RuizDev-117/BioGelato/hardware/ENCLOSURE/Utils/reference.png

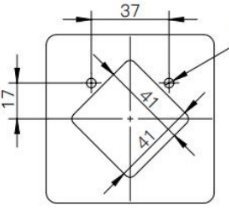
hardware/ENCLOSURE/Utils/reference.png
