RuizDev-117/BioGelato/hardware/PCB/BOM.xlsx

No. | Quantity | Comment | Designator | Footprint | Value | Manufacturer Part | Manufacturer | Supplier Part | Supplier | JLCPCB Stock | JLCPCB Price | Category
1 | 2 | 2.7nF | C1,C17 | C0805 | 2.7nF | CL21B272KBANNNC | SAMSUNG(三星) | C170119 | LCSC | 8417 | 0.0036 | Capacitors:Multilayer Ceramic Capacitors MLCC - SMD/SMT
2 | 4 | 10uF | C2,C4,C13,C14 | C0805 | 10uF | CL21A106KAYNNNE | SAMSUNG(三星) | C15850 | LCSC | 8339426 | 0.0129 | Capacitors:Multilayer Ceramic Capacitors MLCC - SMD/SMT
3 | 4 | 100nF | C3,C5,C9,C15 | C0805 | 100nF | CL21B104KCFNNNE | SAMSUNG(三星) | C28233 | LCSC | 1776398 | 0.006 | Capacitors:Multilayer Ceramic Capacitors MLCC - SMD/SMT
4 | 1 | 1uF | C6 | C0805 | 1uF | CL21B105KBFNNNE | SAMSUNG(三星) | C28323 | LCSC | 4206251 | 0.0066 | Capacitors:Multilayer Ceramic Capacitors MLCC - SMD/SMT
5 | 5 | 22uF | C7,C8,C10,C11,C12 | C0805 | 22uF | CL21A226MAQNNNE | SAMSUNG(三星) | C45783 | LCSC | 5388746 | 0.0384 | Capacitors:Multilayer Ceramic Capacitors MLCC - SMD/SMT
6 | 1 | 10nF | C16 | C0805 | 10nF | CL21B103KBANNNC | SAMSUNG(三星) | C1710 | LCSC | 3236198 | 0.002 | Capacitors:Multilayer Ceramic Capacitors MLCC - SMD/SMT
7 | 1 | SS54 | D1 | SMA_L4.4-W2.8-LS5.4-R-RD |  | SS54 | MDD(辰达半导体) | C22452 | LCSC | 2501779 | 0.0066 | Diodes:Schottky Diodes
8 | 1 | SMAJ16CA-E3/61 | D2 | SMA_L4.2-W2.7-LS5.1-BI |  | SMAJ16CA-E3/61 | VISHAY(威世) | C1973110 | LCSC | 29761 | 0.0214 | Circuit Protection:ESD and Surge Protection (TVS/ESD)
9 | 10 | ESD5Z5.0T1G | D3,D4,D5,D6,D7,D8,D9,D10,D11,D12 | SOD-523F_L1.2-W0.8-LS1.7-RD |  | ESD5Z5.0T1G | onsemi(安森美) | C82044 | LCSC | 351374 | 0.0055 | Circuit Protection:ESD and Surge Protection (TVS/ESD)
10 | 1 | BZT52C6V2-7-F | D13 | SOD-123_L2.7-W1.6-LS3.7-RD-1 |  | BZT52C6V2-7-F | DIODES(美台) | C397931 | LCSC | 20504 | 0.007 | Diodes:Zener Diodes
11 | 1 | 12v DC 2A | DC1 | DC-IN-TH_DC005-T20 |  | DC005-T20 | SOFNG(硕方) | C111567 | LCSC | 14940 | 0.0346 | Connectors:DC Power Connectors
12 | 1 | MPZ2012S221AT000 | L1 | L0805 |  | MPZ2012S221AT000 | TDK | C76818 | LCSC | 132158 | 0.0049 | Filters:Ferrite Beads
13 | 1 | 4.7uH | L2 | IND-SMD_L12.0-W12.0_CDRH127XX | 4.7uH | CDRH127L125NP-4R7NC | Sumida(胜美达) | C2835875 | LCSC | 1759 | 0.1589 | Inductors, Coils, Chokes:Power Inductors
14 | 3 | MMBT3904LT1G | Q1,Q4,Q6 | SOT-23-3_L2.9-W1.6-P1.90-LS2.8-BR |  | MMBT3904LT1G | onsemi(安森美) | C81464 | LCSC | 2249115 | 0.0026 | Transistors/Thyristors:Bipolar (BJT)
15 | 1 | IRLZ44N(UMW) | Q2 | TO-220-3_L10.2-W4.5-P2.54-L |  | IRLZ44N(UMW) | UMW(友台半导体) | C42370423 | LCSC | 6914 | 0.0573 | Transistors/Thyristors:MOSFETs
16 | 1 | MMBT3906LT1G | Q3 | SOT-23-3_L2.9-W1.3-P1.90-LS2.4-BR |  | MMBT3906LT1G | onsemi(安森美) | C53444 | LCSC | 1092785 | 0.0029 | Transistors/Thyristors:Bipolar (BJT)
17 | 2 | AO3401A | Q5,Q7 | SOT-23_L2.9-W1.3-P1.90-LS2.4-BR |  | AO3401A | AOS | C15127 | LCSC | 752896 | 0.0145 | Transistors/Thyristors:MOSFETs
18 | 3 | 10Ω | R1,R3,R5 | R0805_NEW | 10Ω | 0805W8F100JT5E | UNI-ROYAL(厚声) | C17415 | LCSC | 6900906 | 0.0007 | Resistors:Chip Resistor - Surface Mount
19 | 2 | 1kΩ | R2,R6 | R0805 | 1kΩ | 0805W8F1001T5E | UNI-ROYAL(厚声) | C17513 | LCSC | 25333230 | 0.0007 | Resistors:Chip Resistor - Surface Mount
20 | 2 | 100kΩ | R4,R15 | R0805 | 100kΩ | 0805W8F1003T5E | UNI-ROYAL(厚声) | C149504 | LCSC | 5377733 | 0.0009 | Resistors:Chip Resistor - Surface Mount
21 | 3 | 10kΩ | R7,R13,R14 | R0805 | 10kΩ | 0805W8F1002T5E | UNI-ROYAL(厚声) | C17414 | LCSC | 54119008 | 0.0009 | Resistors:Chip Resistor - Surface Mount
22 | 3 | 30Ω | R8,R9,R10 | R0805 | 30Ω | 0805W8F300JT5E | UNI-ROYAL(厚声) | C17622 | LCSC | 190726 | 0.0005 | Resistors:Chip Resistor - Surface Mount
23 | 2 | 4.7kΩ | R11,R12 | R0805 | 4.7kΩ | 0805W8F4701T5E | UNI-ROYAL(厚声) | C17673 | LCSC | 6835645 | 0.0008 | Resistors:Chip Resistor - Surface Mount
24 | 1 | 115kΩ | R16 | R0805 | 115kΩ | RT0805BRD07115KL | YAGEO(国巨) | C865147 | LCSC | 299 | 0.007 | Resistors:Chip Resistor - Surface Mount
25 | 1 | 15.8kΩ | R18 | R0805 | 15.8kΩ | 0805W8F1582T5E | UNI-ROYAL(厚声) | C17468 | LCSC | 13371 | 0.0006 | Resistors:Chip Resistor - Surface Mount
26 | 1 | 22.1kΩ | R19 | R0805 | 22.1kΩ | 0805W8D2212T5E | UNI-ROYAL(厚声) | C422851 | LCSC | 3480 | 0.0011 | Resistors:Chip Resistor - Surface Mount
27 | 4 | Screw-Hole-M3 | SCREW1,SCREW2,SCREW3,SCREW4 | Screw-Hole-M3
28 | 1 | TFT SP1 1.8\" | TFT1 | CONN-TH_8P-P2.50-XH2.54-8P |  | WAFER-XH2.54-8PZZ | XUNPU(讯普) | C5359636 | LCSC | 20075 | 0.0047 | Connectors:Wire To Board Connector
29 | 1 | 470uF | U1 | CAP-TH_BD8.0-P3.50-D0.5-FD | 470uF | 25V470uF CD110 | HRK(鸿瑞凯电子) | C2960234 | LCSC | 29857 | 0.007 | Capacitors:Aluminum Electrolytic Capacitors - Leaded
30 | 1 | ESP32-S3-WROOM-1-N8R8 | U2 | WIRELM-SMD_ESP32-S3-WROOM-1 |  | ESP32-S3-WROOM-1-N8R8 | ESPRESSIF(乐鑫) | C2913201 | LCSC | 2775 | 0.7416 | IoT/Communication Modules:WiFi Modules
31 | 1 | AMS1117-3.3 | U3 | SOT-223-3_L6.5-W3.4-P2.30-LS7.0-BR |  | AMS1117-3.3 | AMS | C6186 | LCSC | 1509785 | 0.0325 | Power Management (PMIC):Voltage Regulators - Linear, Low Drop Out (LDO) Regulators
32 | 1 | AP64501SP-13 | U4 | SOIC-8_L4.9-W3.9-P1.27-LS6.0-BL-EP-1 |  | AP64501SP-13 | DIODES(美台) | C2071517 | LCSC | 2680 | 0.6305 | Power Management (PMIC):DC-DC Converters
33 | 1 | USB-TYPE-C-018 | USB1 | USB-C_SMD-TYPE-C-31-M-12 |  | USB-TYPE-C-018 | DEALON(德艺隆) | C2927038 | LCSC | 37427 | 0.0094 | Connectors:USB Connectors
