RuizDev-117/BioGelato/hardware/ENCLOSURE/3D Models/KK300_MainHousing.stl

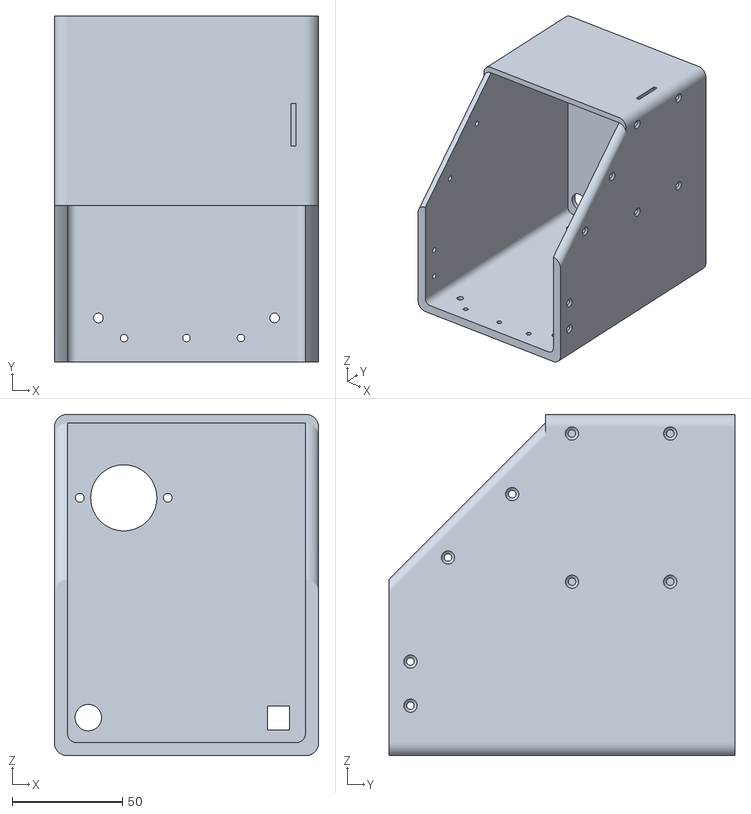
[picture p2: CAD file, 2026-09-02]
hardware/ENCLOSURE/3D Models/KK300_MainHousing.stl
120.0 x 157.1 x 155.0
