RuizDev-117/BioGelato/hardware/ENCLOSURE/3D Models/KK300_HMIPanel.stl

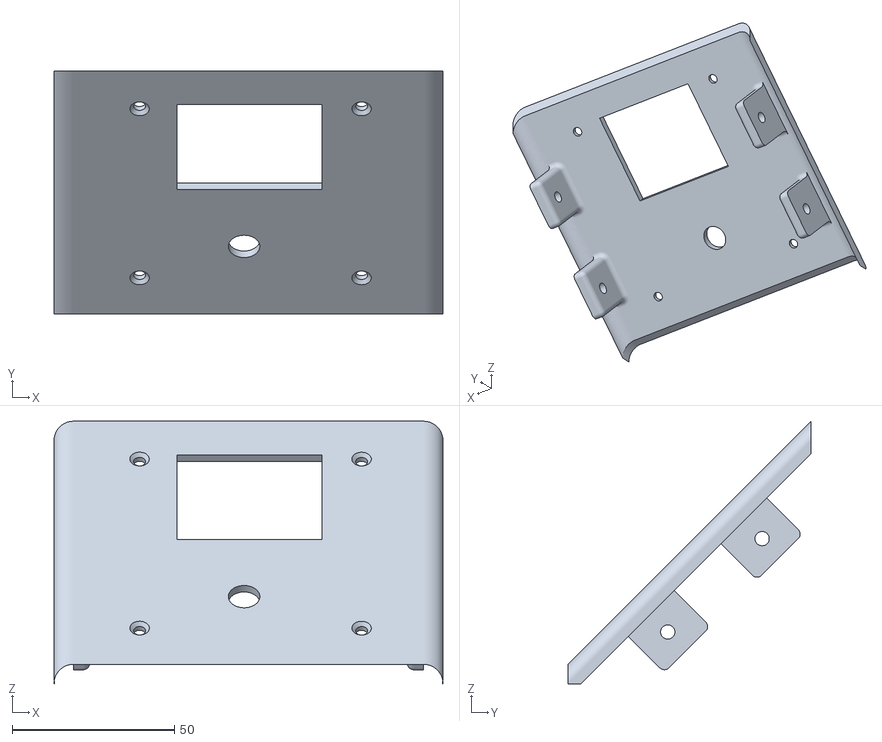
[picture p3: CAD file, 2026-09-02]
hardware/ENCLOSURE/3D Models/KK300_HMIPanel.stl
120.0 x 75.0 x 81.0
