RuizDev-117/BioGelato/hardware/ENCLOSURE/Housing/KK300_Housing.FCStd

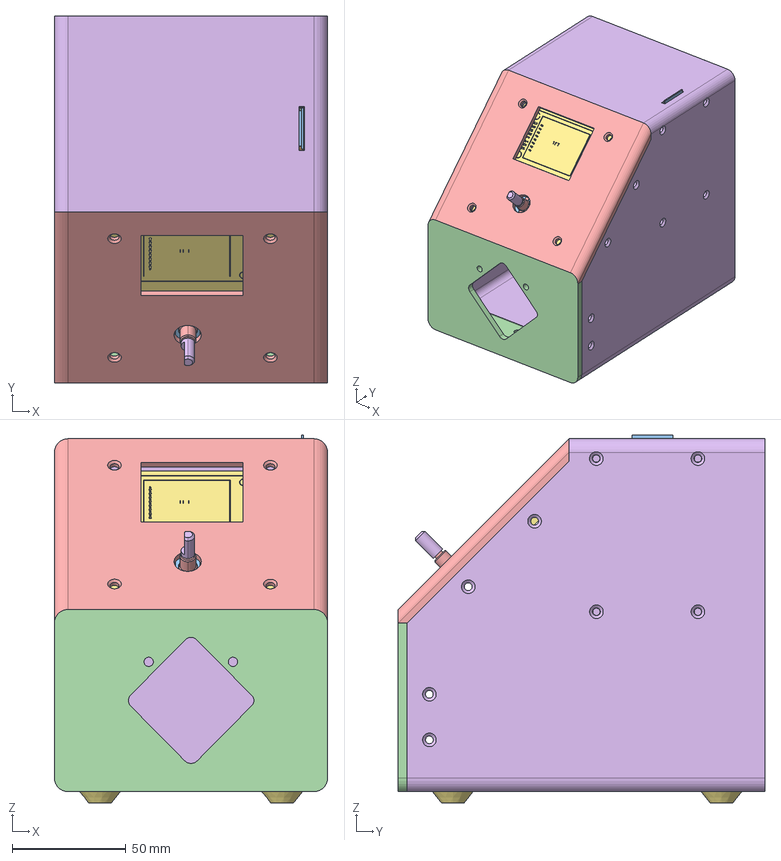
[picture p4: CAD file, 2026-09-02]
hardware/ENCLOSURE/Housing/KK300_Housing.FCStd
120.0 x 161.1 x 161.6 mm
Board~wKMn
SOD-523F_L1.2-W0.8-LS1.7-RD~SOD-523F_L1.2-W0.8-H0.6-LS1.6~wKMn
SOD-523F_L1.2-W0.8-LS1.7-RD~SOD-523F_L1.2-W0.8-H0.6-LS1.6~wKMn001
SOD-523F_L1.2-W0.8-LS1.7-RD~SOD-523F_L1.2-W0.8-H0.6-LS1.6~wKMn002
SOD-523F_L1.2-W0.8-LS1.7-RD~SOD-523F_L1.2-W0.8-H0.6-LS1.6~wKMn003
SOD-523F_L1.2-W0.8-LS1.7-RD~SOD-523F_L1.2-W0.8-H0.6-LS1.6~wKMn004
SOD-523F_L1.2-W0.8-LS1.7-RD~SOD-523F_L1.2-W0.8-H0.6-LS1.6~wKMn005
SOD-523F_L1.2-W0.8-LS1.7-RD~SOD-523F_L1.2-W0.8-H0.6-LS1.6~wKMn006
C0805~C0805_L2.0-W1.3-H1.3~wKMn
C0805~C0805_L2.0-W1.3-H1.3~wKMn001
C0805~C0805_L2.0-W1.3-H1.3~wKMn002
C0805~C0805_L2.0-W1.3-H1.3~wKMn003
C0805~C0805_L2.0-W1.3-H1.3~wKMn004
C0805~C0805_L2.0-W1.3-H1.3~wKMn005
C0805~C0805_L2.0-W1.3-H1.3~wKMn006
C0805~C0805_L2.0-W1.3-H1.3~wKMn007
C0805~C0805_L2.0-W1.3-H1.3~wKMn008
C0805~C0805_L2.0-W1.3-H1.3~wKMn009
C0805~C0805_L2.0-W1.3-H1.3~wKMn010
C0805~C0805_L2.0-W1.3-H1.3~wKMn011
C0805~C0805_L2.0-W1.3-H1.3~wKMn012
C0805~C0805_L2.0-W1.3-H1.3~wKMn013
C0805~C0805_L2.0-W1.3-H1.3~wKMn014
C0805~C0805_L2.0-W1.3-H1.3~wKMn015
SMA_L4.2-W2.7-LS5.1-BI~SMA_L4.2-W2.7-LS5.1-BI~wKMn
SMA_L4.2-W2.7-LS5.1-BI~SMA_L4.2-W2.7-LS5.1-BI~wKMn001
SMA_L4.2-W2.7-LS5.1-BI~SMA_L4.2-W2.7-LS5.1-BI~wKMn002
SMA_L4.2-W2.7-LS5.1-BI~SMA_L4.2-W2.7-LS5.1-BI~wKMn003
SMA_L4.2-W2.7-LS5.1-BI~SMA_L4.2-W2.7-LS5.1-BI~wKMn004
SMA_L4.2-W2.7-LS5.1-BI~SMA_L4.2-W2.7-LS5.1-BI~wKMn005
SMA_L4.2-W2.7-LS5.1-BI~SMA_L4.2-W2.7-LS5.1-BI~wKMn006
SMA_L4.2-W2.7-LS5.1-BI~SMA_L4.2-W2.7-LS5.1-BI~wKMn007
SMA_L4.2-W2.7-LS5.1-BI~SMA_L4.2-W2.7-LS5.1-BI~wKMn008
SMA_L4.2-W2.7-LS5.1-BI~SMA_L4.2-W2.7-LS5.1-BI~wKMn009
SMA_L4.2-W2.7-LS5.1-BI~SMA_L4.2-W2.7-LS5.1-BI~wKMn010
SMA_L4.2-W2.7-LS5.1-BI~SMA_L4.2-W2.7-LS5.1-BI~wKMn011
SMA_L4.2-W2.7-LS5.1-BI~SMA_L4.2-W2.7-LS5.1-BI~wKMn012
SMA_L4.2-W2.7-LS5.1-BI~SMA_L4.2-W2.7-LS5.1-BI~wKMn013
SMA_L4.4-W2.8-LS5.4-R-RD~SMA_L4.4-W2.8-LS5.4-R-RD~wKMn
SMA_L4.4-W2.8-LS5.4-R-RD~SMA_L4.4-W2.8-LS5.4-R-RD~wKMn001
SMA_L4.4-W2.8-LS5.4-R-RD~SMA_L4.4-W2.8-LS5.4-R-RD~wKMn002
SMA_L4.4-W2.8-LS5.4-R-RD~SMA_L4.4-W2.8-LS5.4-R-RD~wKMn003
SMA_L4.4-W2.8-LS5.4-R-RD~SMA_L4.4-W2.8-LS5.4-R-RD~wKMn004
SMA_L4.4-W2.8-LS5.4-R-RD~SMA_L4.4-W2.8-LS5.4-R-RD~wKMn005
SMA_L4.4-W2.8-LS5.4-R-RD~SMA_L4.4-W2.8-LS5.4-R-RD~wKMn006
SMA_L4.4-W2.8-LS5.4-R-RD~SMA_L4.4-W2.8-LS5.4-R-RD~wKMn007
SMA_L4.4-W2.8-LS5.4-R-RD~SMA_L4.4-W2.8-LS5.4-R-RD~wKMn008
SMA_L4.4-W2.8-LS5.4-R-RD~SMA_L4.4-W2.8-LS5.4-R-RD~wKMn009
SMA_L4.4-W2.8-LS5.4-R-RD~SMA_L4.4-W2.8-LS5.4-R-RD~wKMn010
SMA_L4.4-W2.8-LS5.4-R-RD~SMA_L4.4-W2.8-LS5.4-R-RD~wKMn011
SMA_L4.4-W2.8-LS5.4-R-RD~SMA_L4.4-W2.8-LS5.4-R-RD~wKMn012
SMA_L4.4-W2.8-LS5.4-R-RD~SMA_L4.4-W2.8-LS5.4-R-RD~wKMn013
DC-IN-TH_DC005-T20~DC-IN-TH_DC005-T20~wKMn
DC-IN-TH_DC005-T20~DC-IN-TH_DC005-T20~wKMn001
DC-IN-TH_DC005-T20~DC-IN-TH_DC005-T20~wKMn002
DC-IN-TH_DC005-T20~DC-IN-TH_DC005-T20~wKMn003
R0805_NEW~R0805_L2.0-W1.3-H0.6~wKMn
R0805_NEW~R0805_L2.0-W1.3-H0.6~wKMn001
R0805_NEW~R0805_L2.0-W1.3-H0.6~wKMn002
R0805_NEW~R0805_L2.0-W1.3-H0.6~wKMn004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
