RuizDev-117/BioGelato/hardware/ENCLOSURE/PCB MODELS/3D_PCB1.step

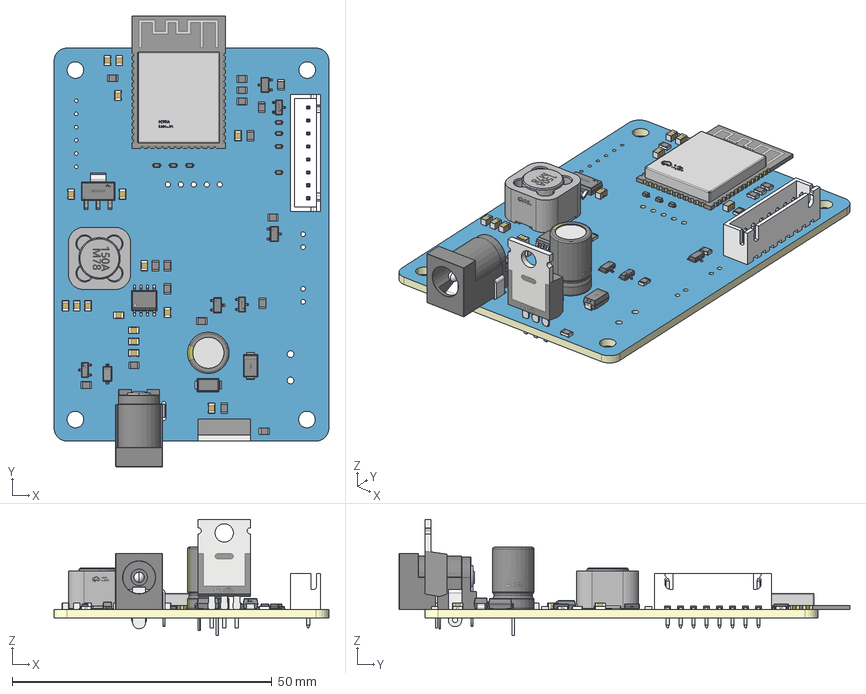
[picture p5: CAD file, 2026-09-02]
hardware/ENCLOSURE/PCB MODELS/3D_PCB1.step
52.9 x 86.7 x 22.3 mm
Board~wKMn
TopCopper~wKMn
BottomCopper~wKMn
TopSilkscreen~wKMn
BottomSilkscreen~wKMn
TopFpcStiffener~wKMn
BottomFpcStiffener~wKMn
SOD-523F_L1.2-W0.8-LS1.7-RD~SOD-523F_L1.2-W0.8-H0.6-LS1.6~wKMn x 7
C0805~C0805_L2.0-W1.3-H1.3~wKMn x 16
SMA_L4.2-W2.7-LS5.1-BI~SMA_L4.2-W2.7-LS5.1-BI~wKMn
SMA_L4.4-W2.8-LS5.4-R-RD~SMA_L4.4-W2.8-LS5.4-R-RD~wKMn
DC-IN-TH_DC005-T20~DC-IN-TH_DC005-T20~wKMn
R0805_NEW~R0805_L2.0-W1.3-H0.6~wKMn x 16
L0805~R0805_L2.0-W1.3-H0.6~wKMn
SOD-123_L2.7-W1.6-LS3.7-RD-1~SOD-123_L2.7-W1.6-LS3.7-RD-1~wKMn
TO-220-3_L10.2-W4.5-P2.54-L~TO-220-3_L10.2-W4.5-P2.54-L~wKMn
IND-SMD_L12.0-W12.0_CDRH127XX~IND-SMD_L12.0-W12.0-H8.0_CDRH127XX~wKMn
SOT-23-3_L2.9-W1.6-P1.90-LS2.8-BR~SOT-23-3L_ L2.9-W1.6-H1.1-LS2.8-P0.95~wKMn x 3
CONN-TH_8P-P2.50-XH2.54-8P~CONN-TH_8P-P2.50-XH2.54-8P~wKMn
CAP-TH_BD8.0-P3.50-D0.5-FD~CAP-TH_BD8.0-P3.50-D0.5-FD~wKMn
WIRELM-SMD_ESP32-S3-WROOM-1~WIRELM-SMD_ESP32-S3-WROOM-1~wKMn
SOT-23_L2.9-W1.3-P1.90-LS2.4-BR~SOT-23-3P_ L2.9-W1.3-H1.0-LS2.4-P0.95~wKMn x 2
SOT-23-3_L2.9-W1.3-P1.90-LS2.4-BR~SOT-23-3P_ L2.9-W1.3-H1.0-LS2.4-P0.95~wKMn
SOIC-8_L4.9-W3.9-P1.27-LS6.0-BL-EP-1~SOIC-8_ L4.9-W3.9-P1.27-LS6.0-BL-EP-1~wKMn
SOT-223-3_L6.5-W3.4-P2.30-LS7.0-BR~SOT-223-4P_ L6.5-W3.5-H1.6-LS7.0-P2.30~wKMn
