RuizDev-117/BioGelato/hardware/ENCLOSURE/PCB MODELS/3D_PCB2.step

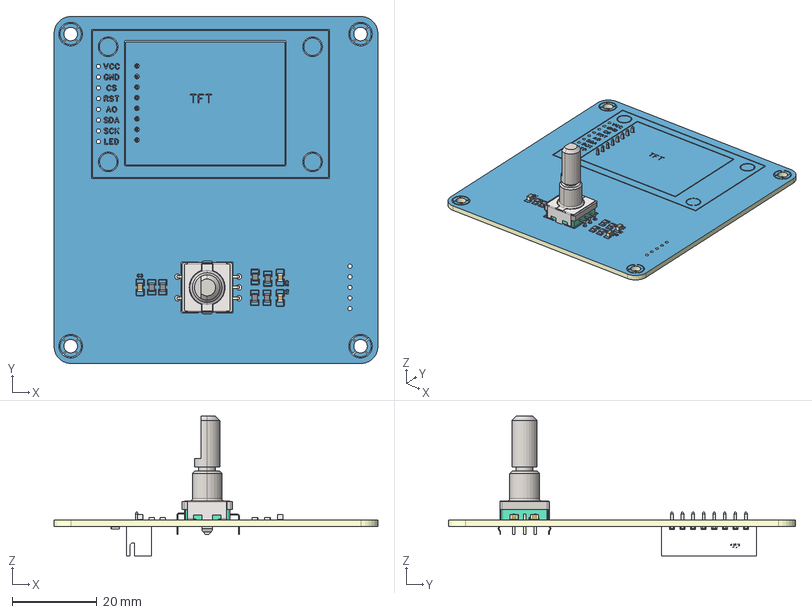
[picture p6: CAD file, 2026-09-02]
hardware/ENCLOSURE/PCB MODELS/3D_PCB2.step
76.5 x 82.0 x 33.0 mm
Board~ZfcR
TopCopper~ZfcR
BottomCopper~ZfcR
TopSilkscreen~ZfcR x 66
BottomSilkscreen~ZfcR x 26
TopFpcStiffener~ZfcR
BottomFpcStiffener~ZfcR
C0805~C0805_L2.0-W1.3-H1.3~ZfcR x 3
CONN-TH_8P-P2.50-XH2.54-8P~CONN-TH_8P-P2.50-XH2.54-8P~ZfcR
R0805~R0805_L2.0-W1.3-H0.6~ZfcR x 7
SW-TH_EC11XXXXXXXX~SW-TH_ EC11XXXXXXXX-L11.7-W12.0-H24.5-P2.5-LS14.5~ZfcR
