RuizDev-117/BioGelato/hardware/ENCLOSURE/3D Models/KK300_PeristalticPanel.stl

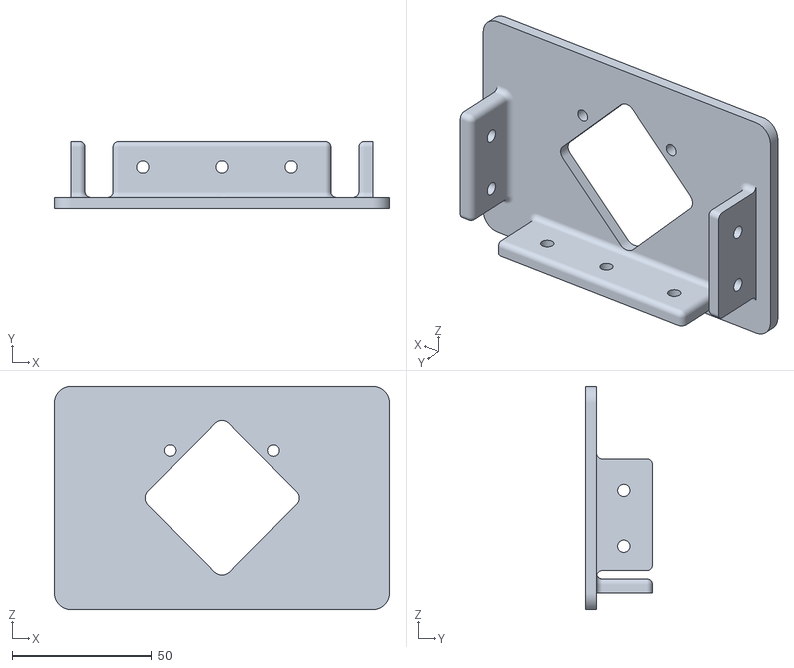
[picture p7: CAD file, 2026-09-02]
hardware/ENCLOSURE/3D Models/KK300_PeristalticPanel.stl
120.0 x 24.0 x 80.0
