RuizDev-117/BioGelato/hardware/ENCLOSURE/3D Models/KK300_BodySuports.stl

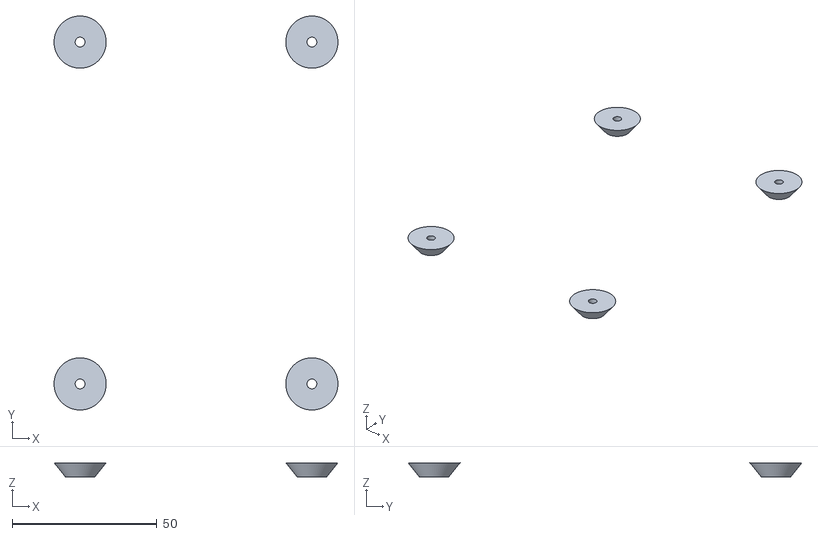
[picture p8: CAD file, 2026-09-02]
hardware/ENCLOSURE/3D Models/KK300_BodySuports.stl
98.0 x 136.0 x 5.00
