RuizDev-117/BioGelato/hardware/PCB/Schematic/HMI_PCB.pdf

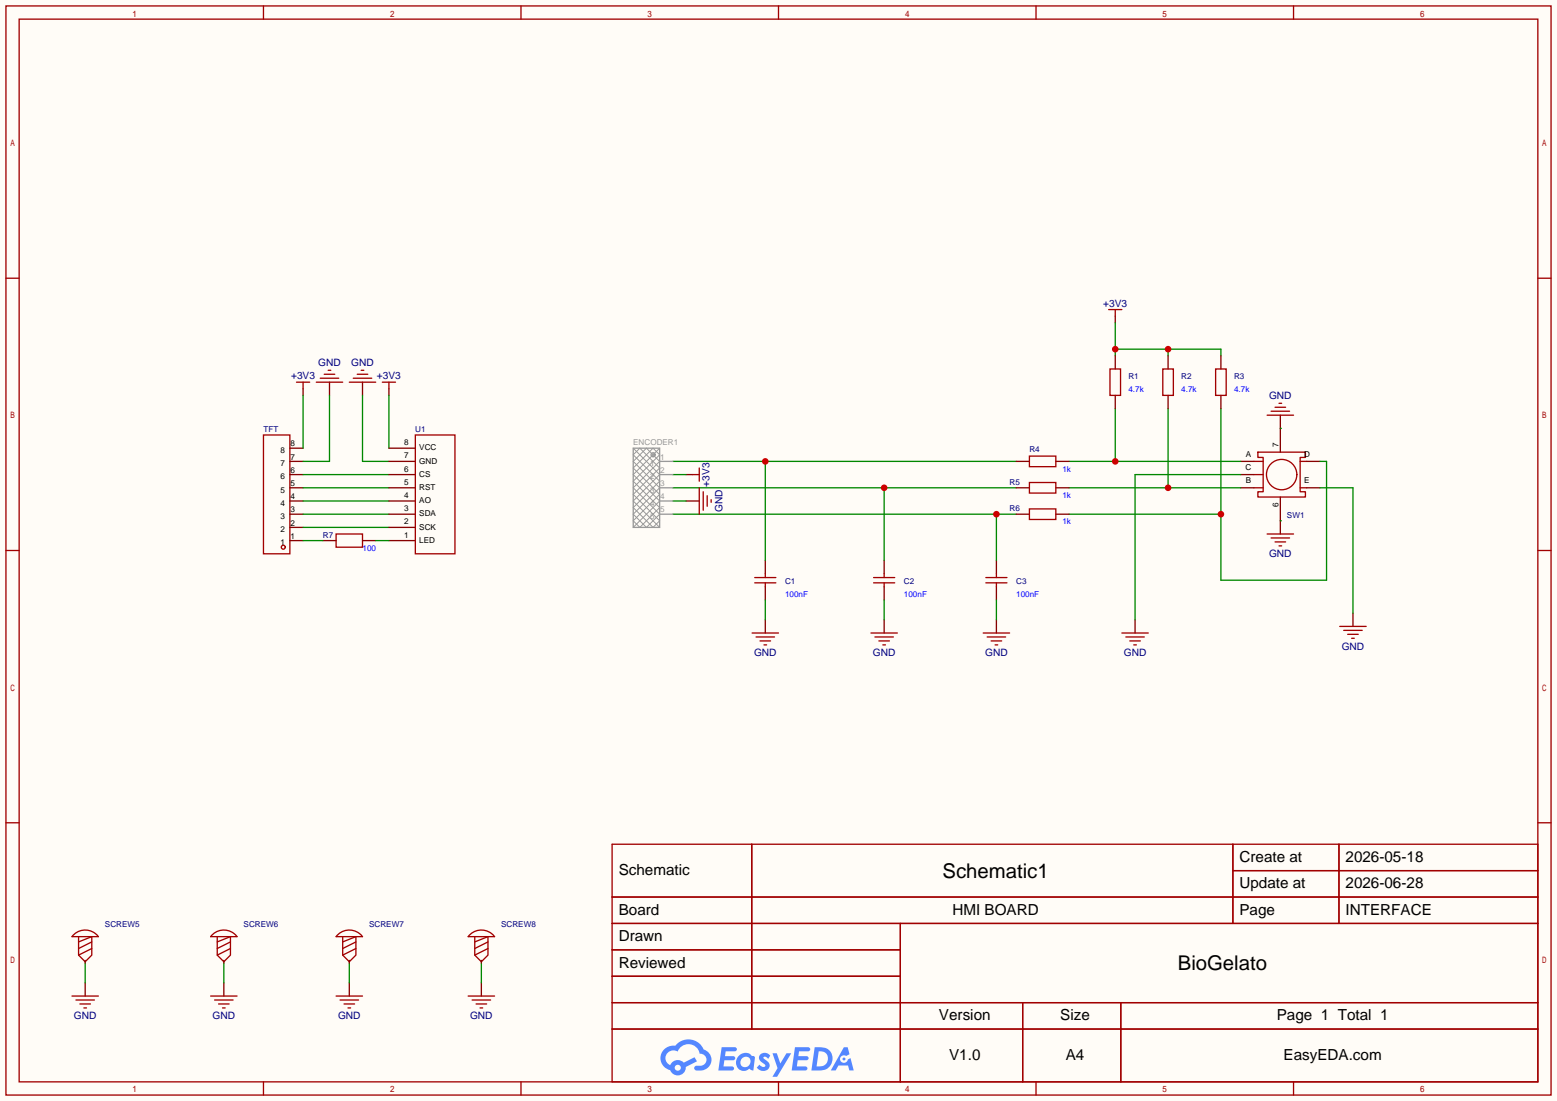
[picture p22: page 1]

Schematic | Schematic1 | Create at | 2026-05-18

Update at | 2026-06-28

Board | HMI BOARD | Page | INTERFACE
Drawn | | BioGelato
Reviewed

Version | Size | Page 1 Total 1

V1.0 | A4 | EasyEDA.com
