RuizDev-117/BioGelato/hardware/PCB/Schematic/Main_PCB.pdf

+12V

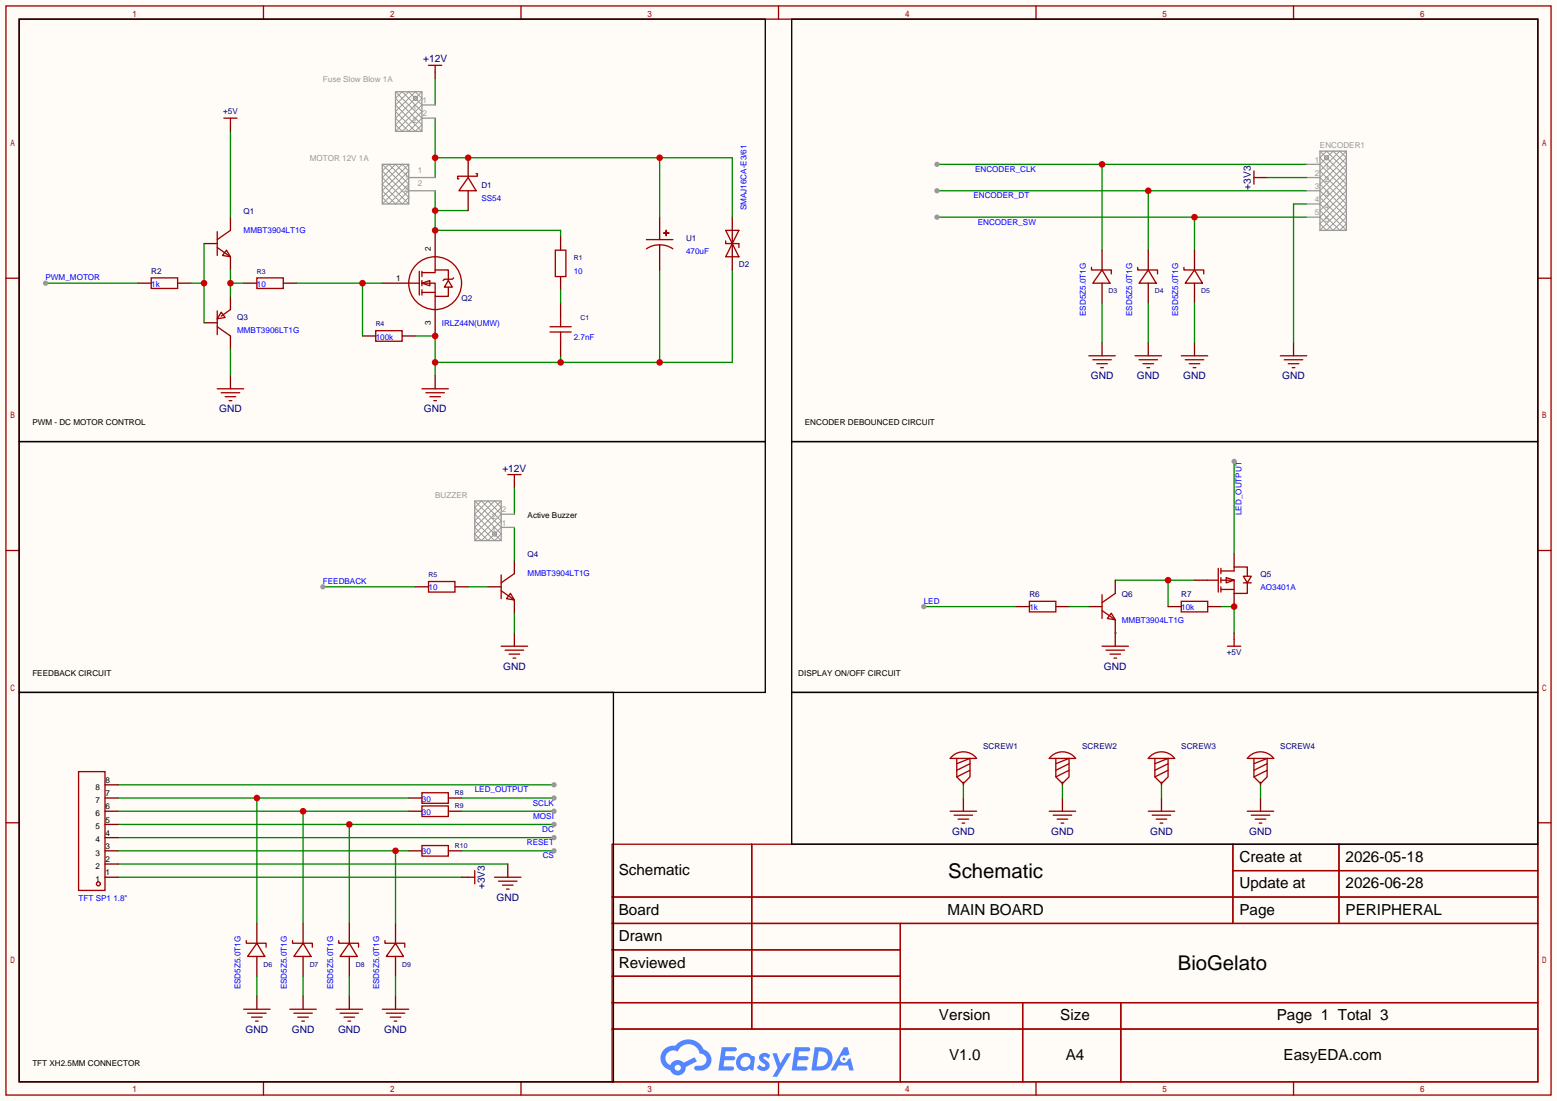
[picture p23: page 1]

PWM - DC MOTOR CONTROL

DISPLAY ON/OFF CIRCUIT

Schematic | Schematic | Create at | 2026-05-18

Update at | 2026-06-28

Board | MAIN BOARD | Page | PERIPHERAL
Drawn | | BioGelato
Reviewed

Version | Size | Page 1 Total 3

V1.0 | A4 | EasyEDA.com

GND | GND
GND | GND | GND

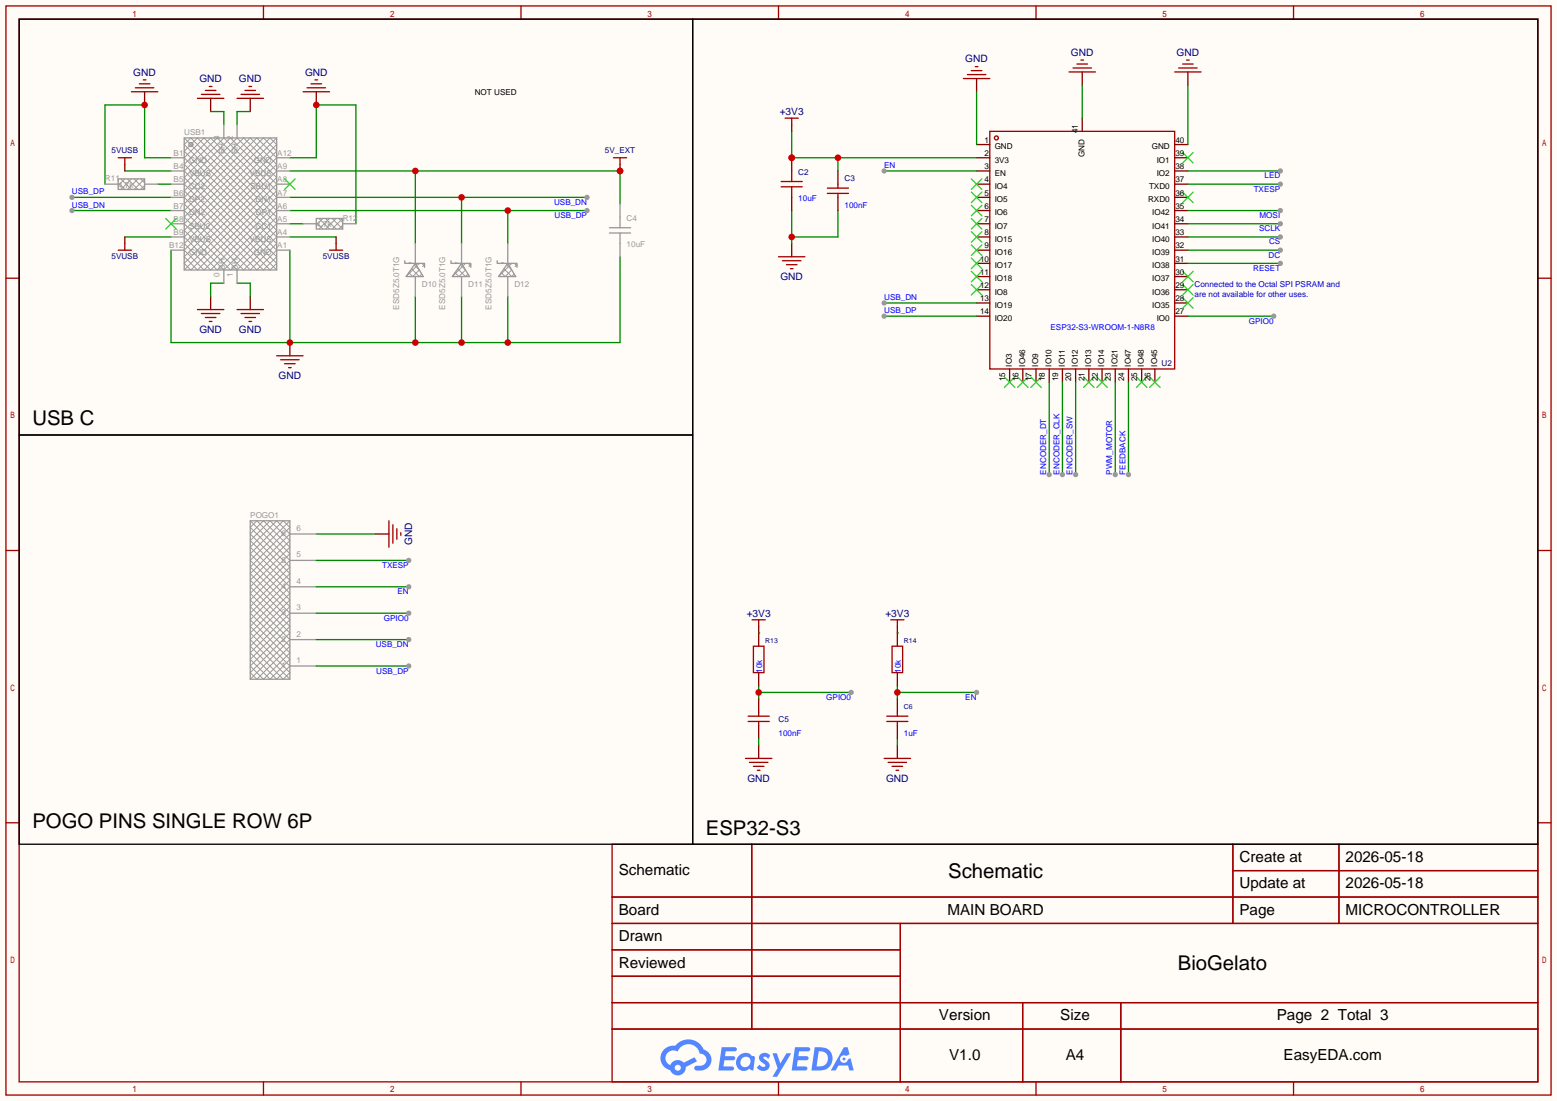
[picture p24: page 2]

Connected to the Octal SPI PSRAM and
are not available for other uses.

POGO PINS SINGLE ROW 6P

Schematic | Schematic | Create at | 2026-05-18

Update at | 2026-05-18

Board | MAIN BOARD | Page | MICROCONTROLLER
Drawn | | BioGelato
Reviewed

+3V3
+12V

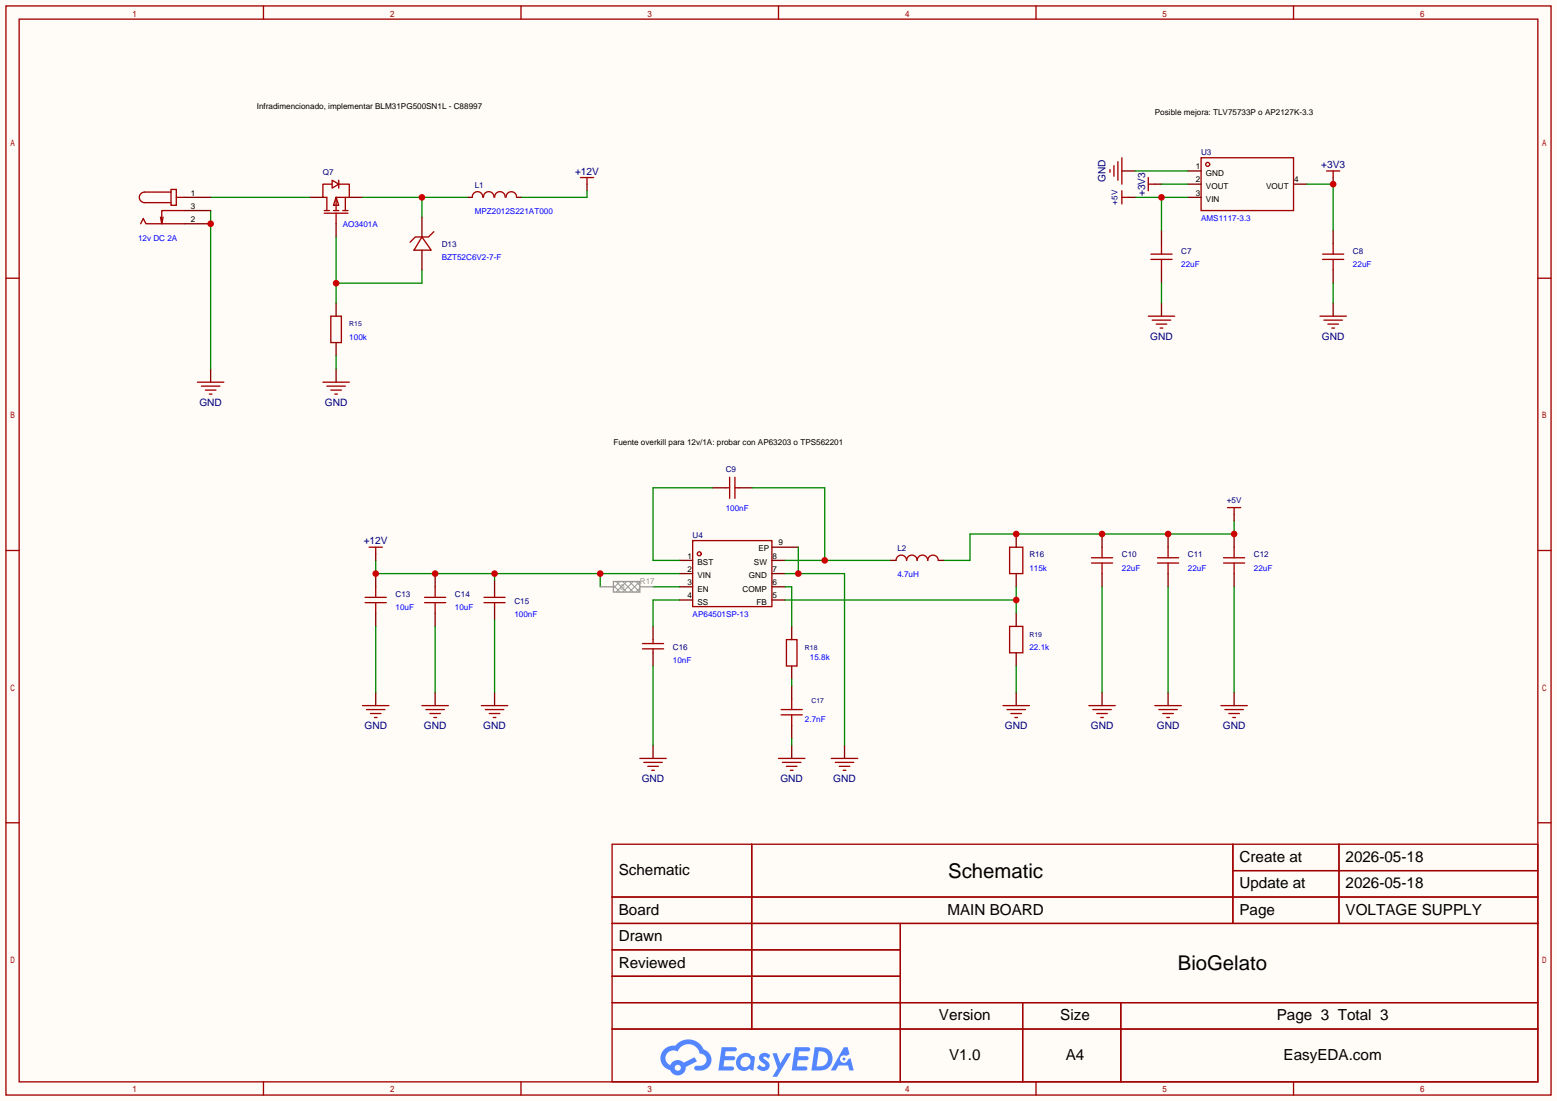
[picture p25: page 3]

Fuente overkill para 12v/1A: probar con AP63203 o TPS562201

Schematic | Schematic | Create at | 2026-05-18

Update at | 2026-05-18

Board | MAIN BOARD | Page | VOLTAGE SUPPLY
Drawn | | BioGelato
Reviewed
